pekarekmarek/pozarni_casomira/Fotky/nabijeni.jpg

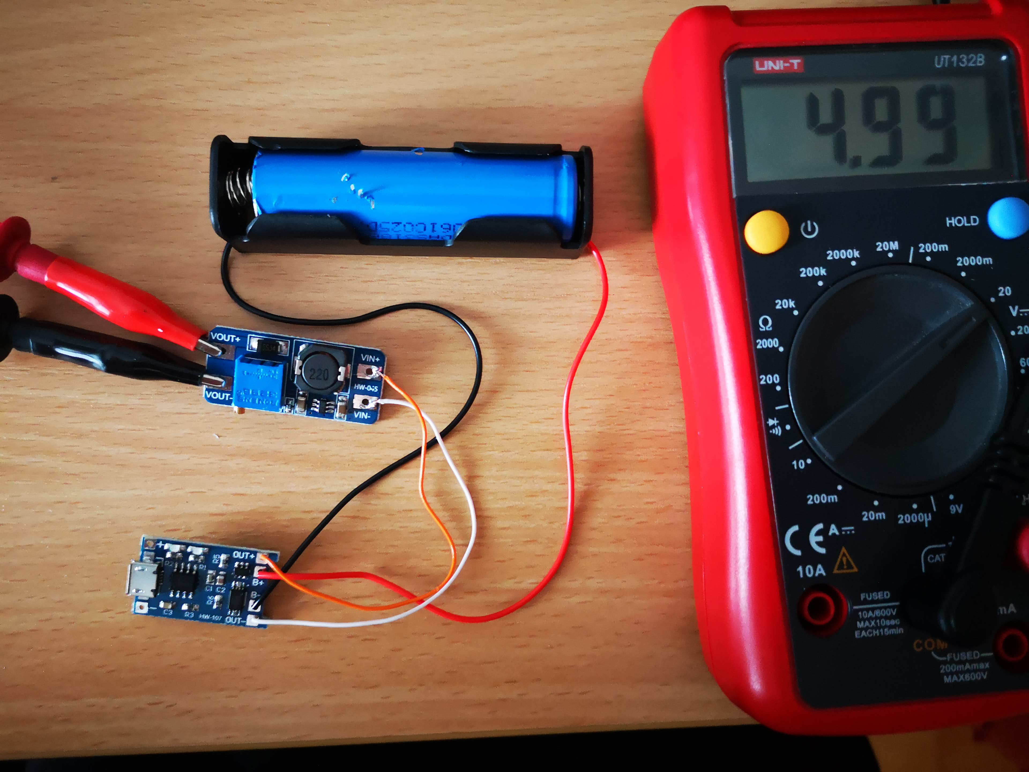
Fotky/nabijeni.jpg
