pekarekmarek/pozarni_casomira/Fotky/IMG_20210119_134516.jpg

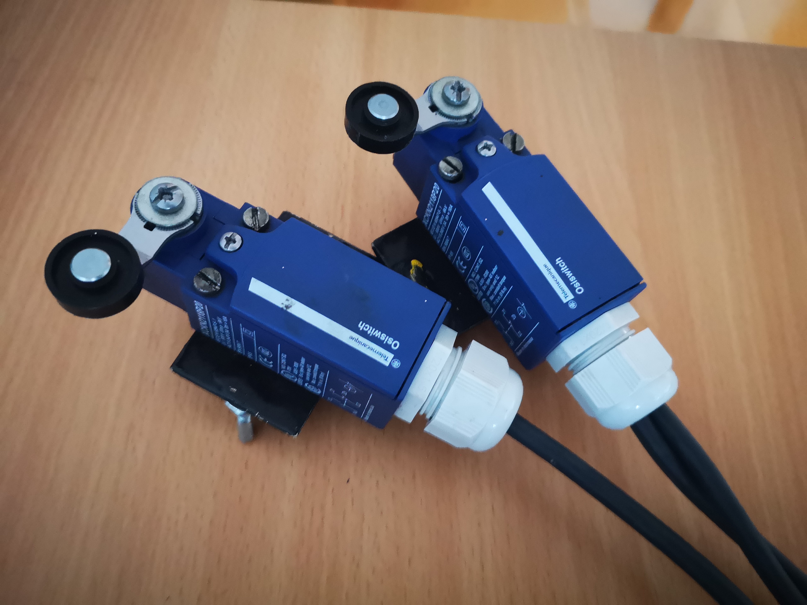
Fotky/IMG_20210119_134516.jpg
