pekarekmarek/pozarni_casomira/Blokové schéma/Blokove_schema.png

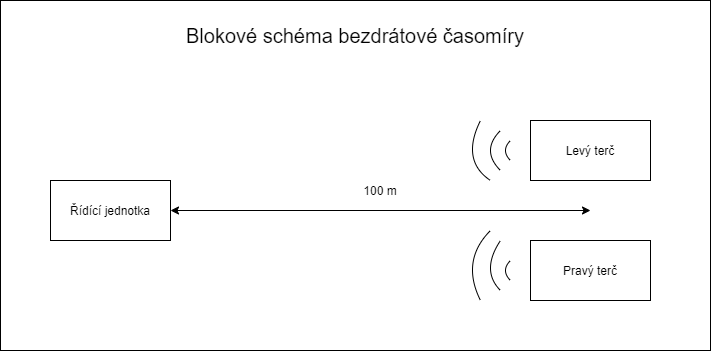
Blokové schéma/Blokove_schema.png
