pekarekmarek/pozarni_casomira/Blokové schéma/Ridici_jednotka.png

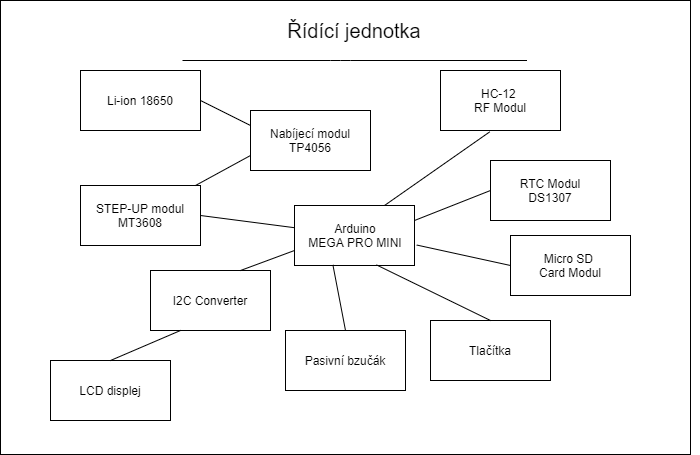
Blokové schéma/Ridici_jednotka.png
