pekarekmarek/pozarni_casomira/Blokové schéma/Terce.png

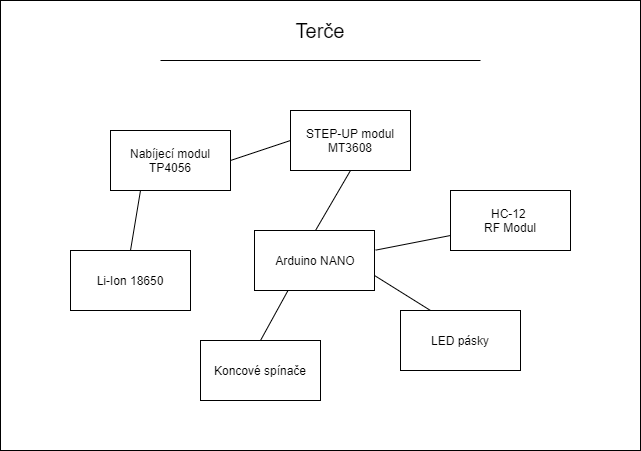
Blokové schéma/Terce.png
