pekarekmarek/pozarni_casomira/Fotky/IMG_20210119_134104.jpg

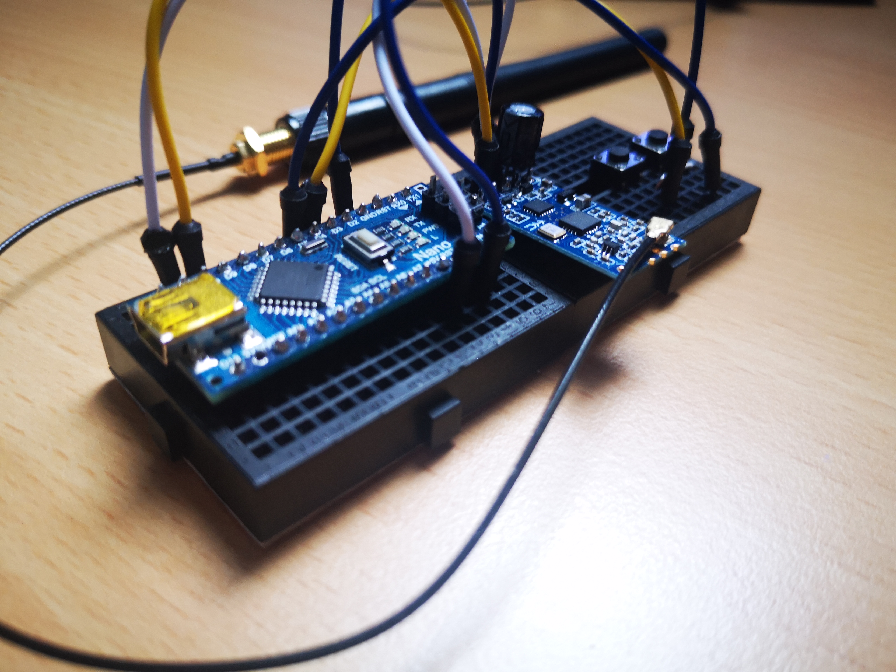
Fotky/IMG_20210119_134104.jpg
