pekarekmarek/pozarni_casomira/Fotky/Ridici_jednotka_vnitrek.PNG

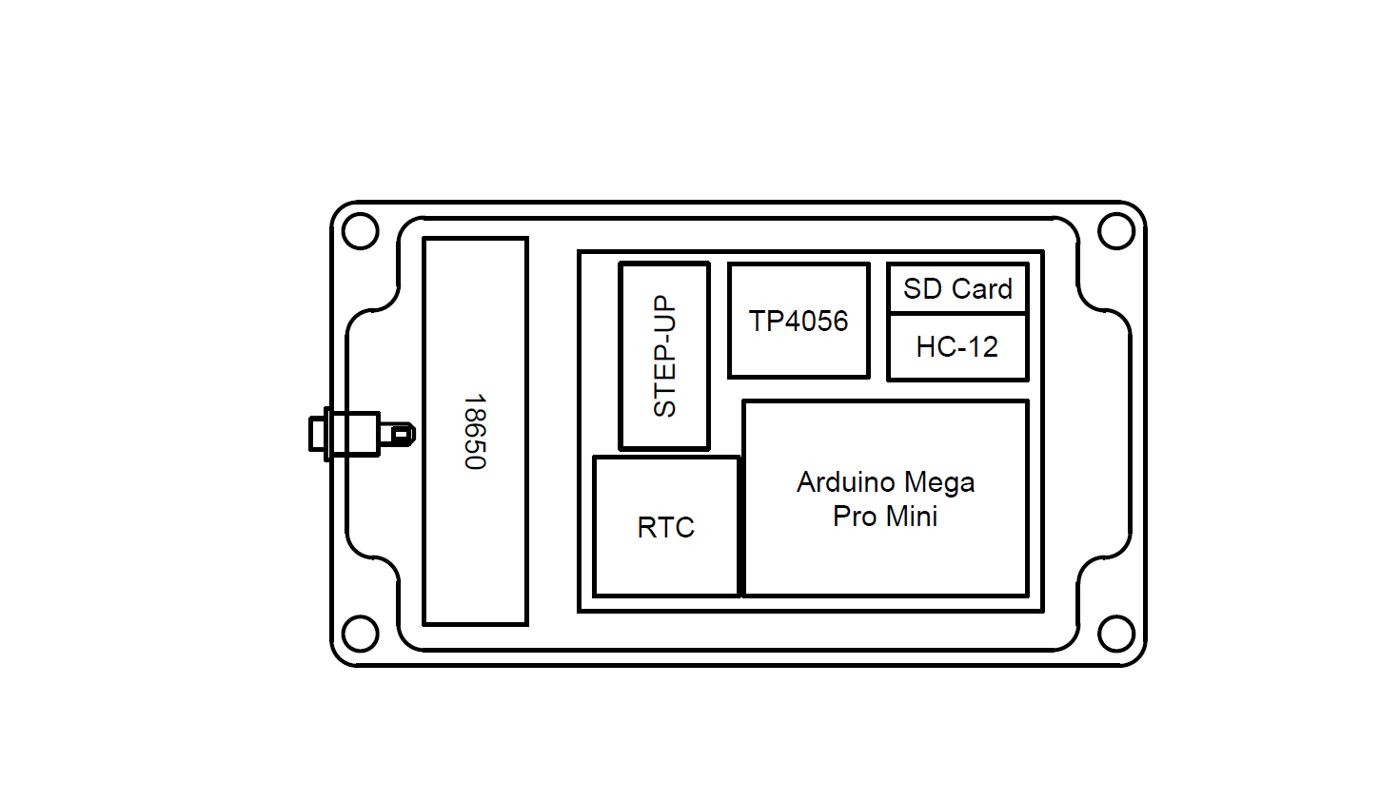
Fotky/Ridici_jednotka_vnitrek.PNG
