pekarekmarek/pozarni_casomira/Fotky/Ridici_jednotka_vrsek.PNG

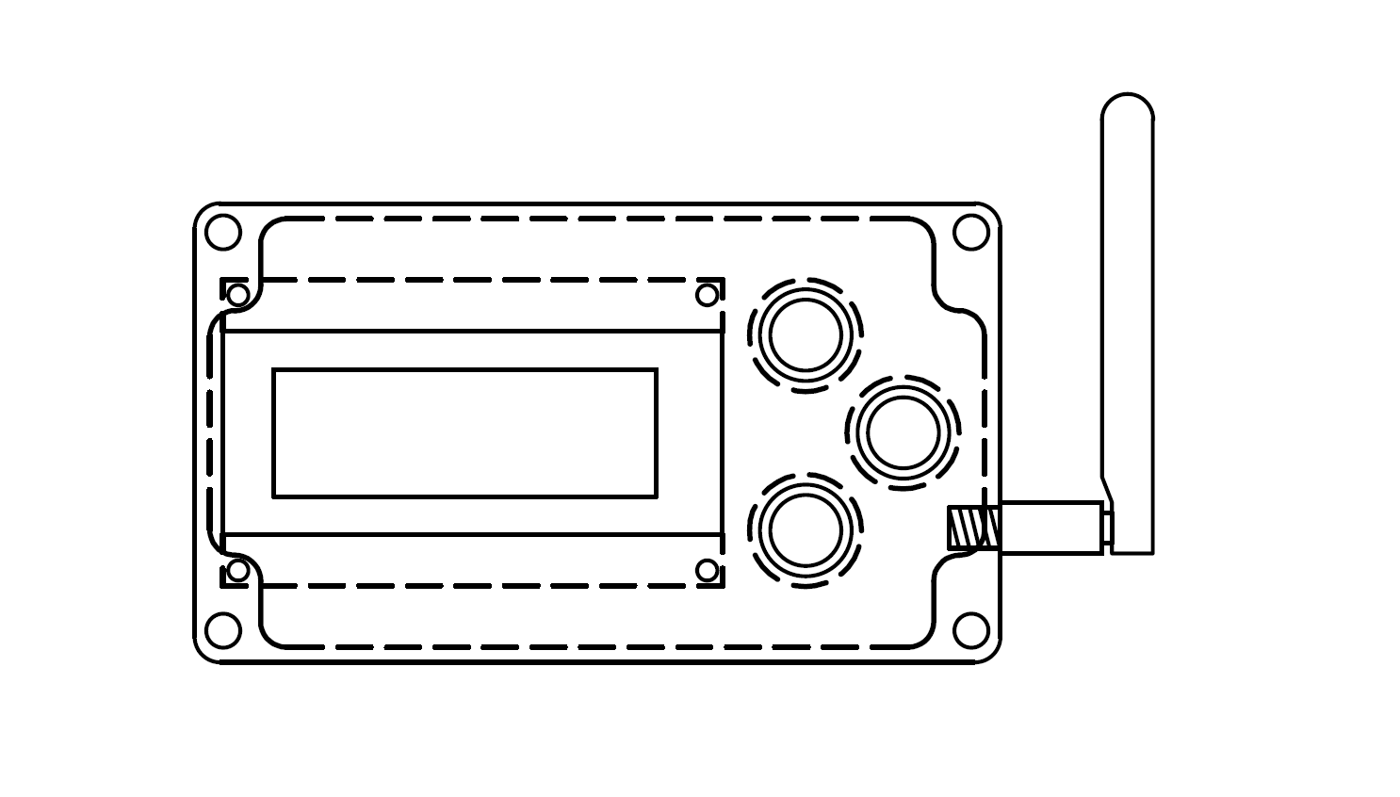
Fotky/Ridici_jednotka_vrsek.PNG
