pekarekmarek/pozarni_casomira/Fotky/terce_vnitrek.PNG

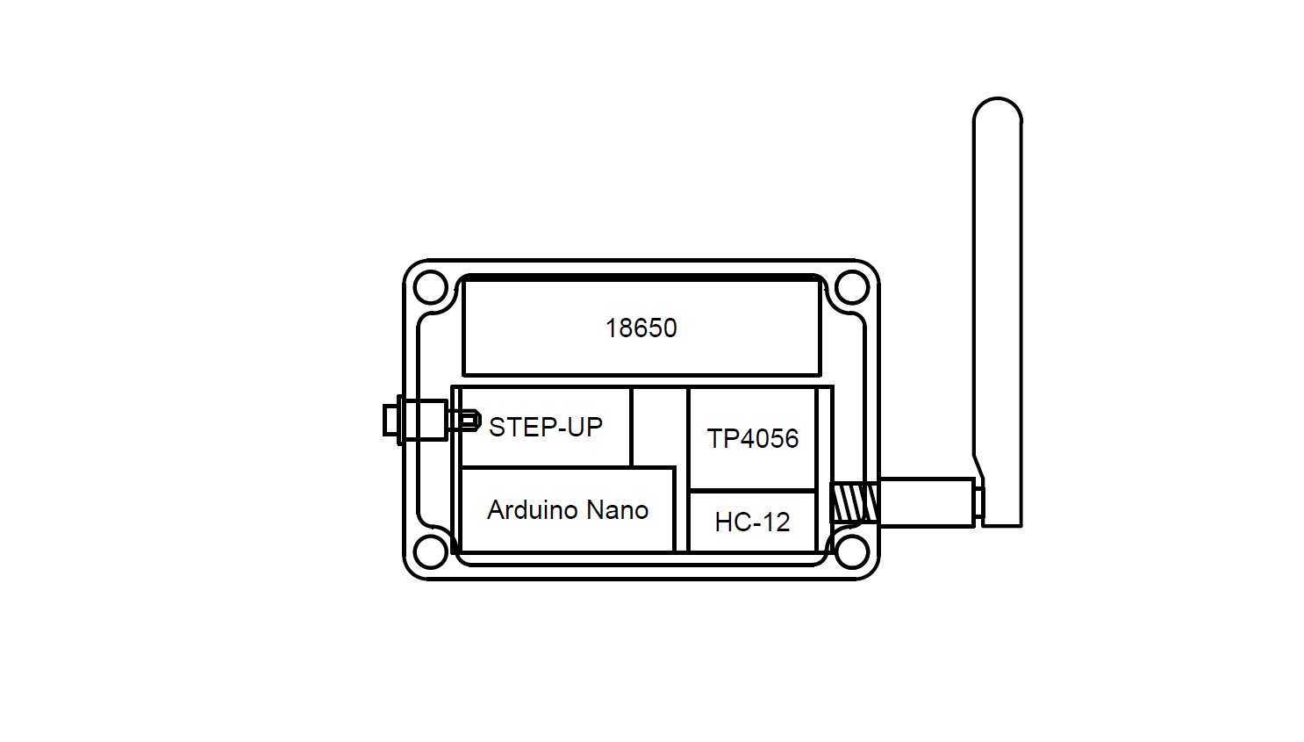
Fotky/terce_vnitrek.PNG
