pekarekmarek/pozarni_casomira/Schéma zapojení/Terče.png

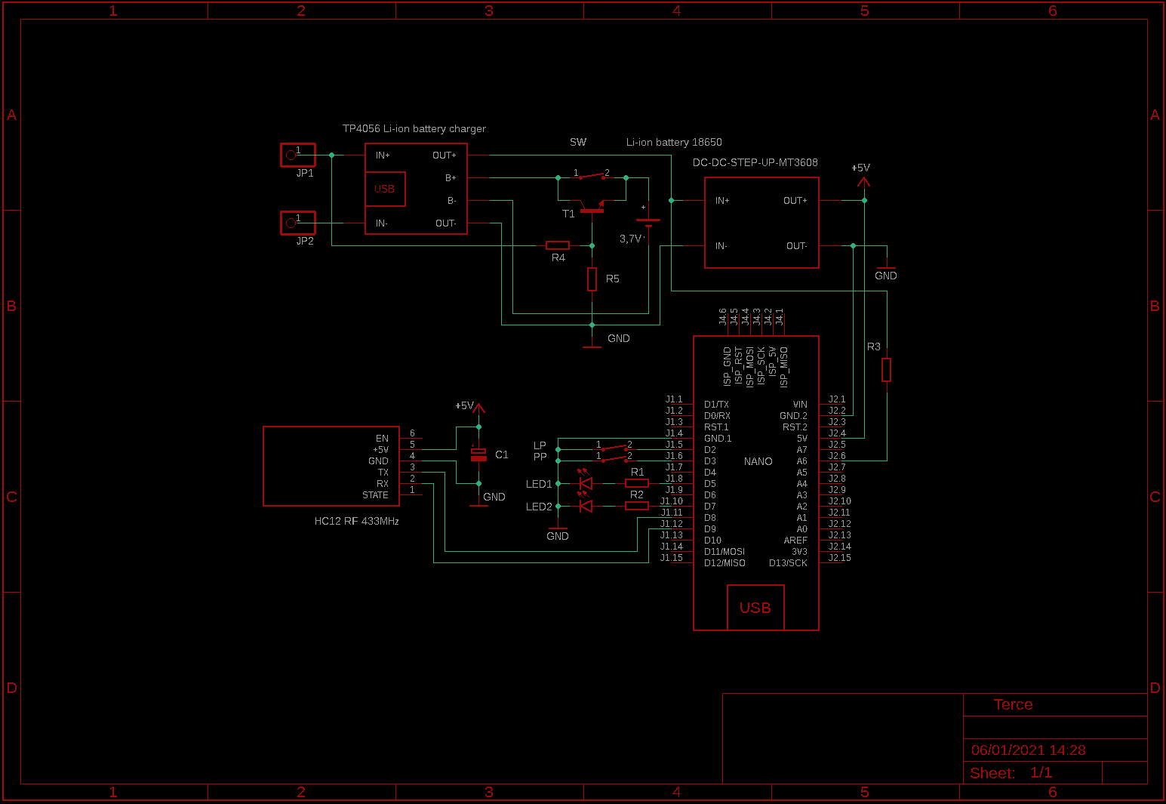
Schéma zapojení/Terče.png
