pekarekmarek/pozarni_casomira/Schéma zapojení/Řídící jednotka.png

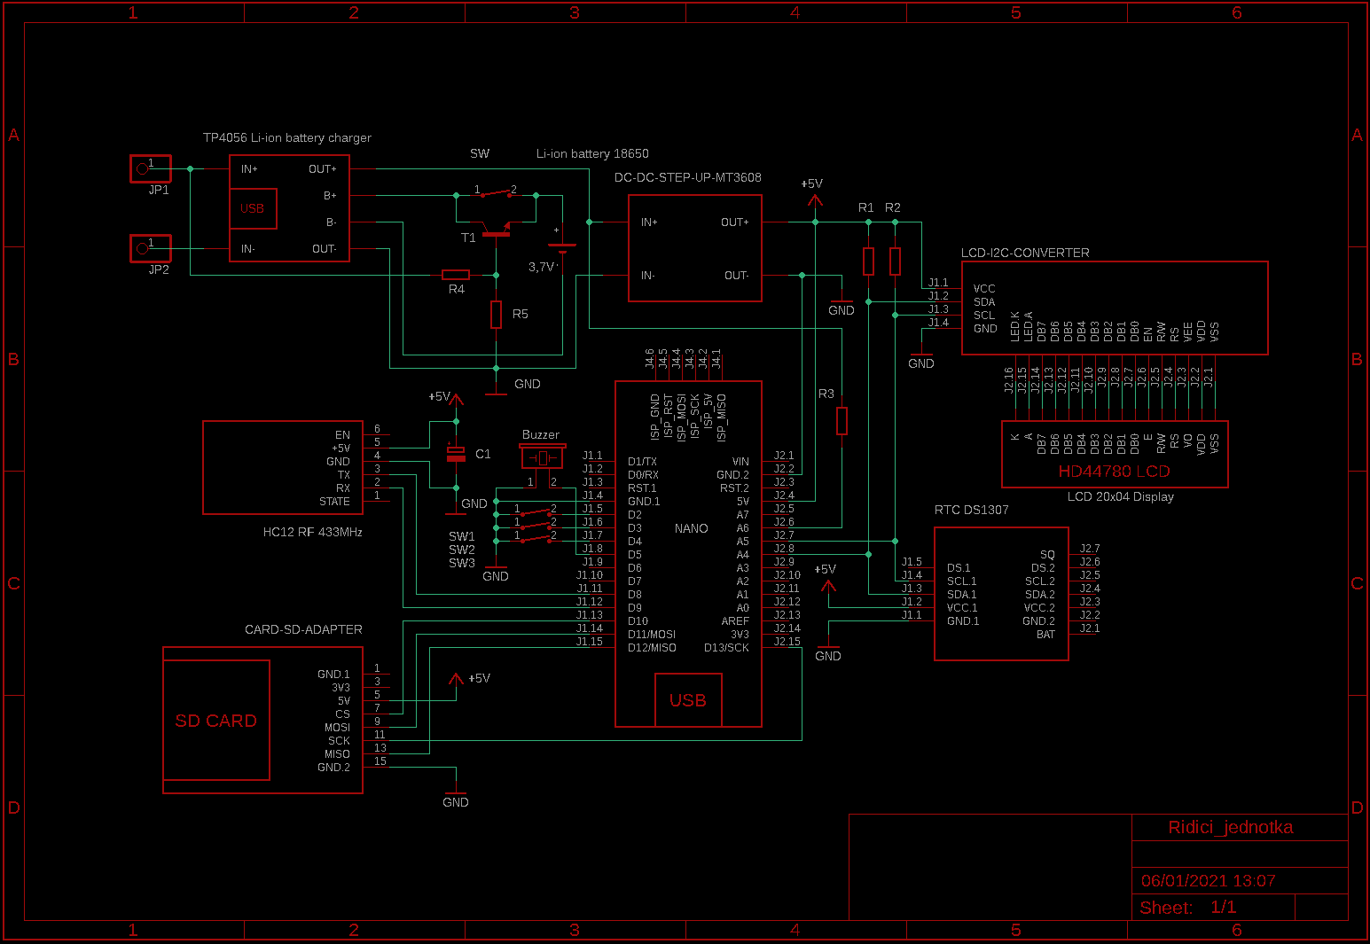
Schéma zapojení/Řídící jednotka.png
