pekarekmarek/pozarni_casomira/(commit log)

2021-01-20 Prototype PCB
2021-02-28 fix menu rf utok
    [main.cpp]
2021-03-02 menu, delete node fix
    [main.cpp]
2021-04-13 fix zmena tymu, smazat -- if !sd.begin,
    [main.cpp]
